mdarnell321/CubeSat-Hardware/Symbols/SFH_2240_A01/SFH_2240_A01.stp

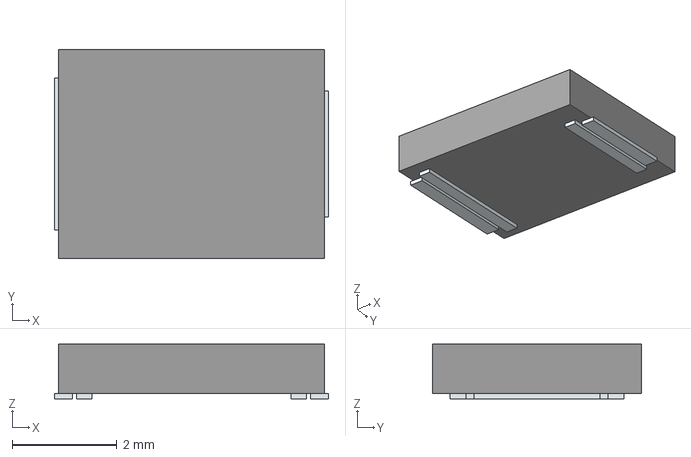
[picture p1: CAD file, 2025-11-14]
Symbols/SFH_2240_A01/SFH_2240_A01.stp
5.24 x 4.00 x 1.05 mm
Pins
