mdarnell321/CubeSat-Hardware/(list of files, cad)

Other CAD files:
Symbols/SFH_2240_A01/SFH_2240_A01.stl
