mdarnell321/CubeSat-Hardware/PDF/Electrical Power System.pdf

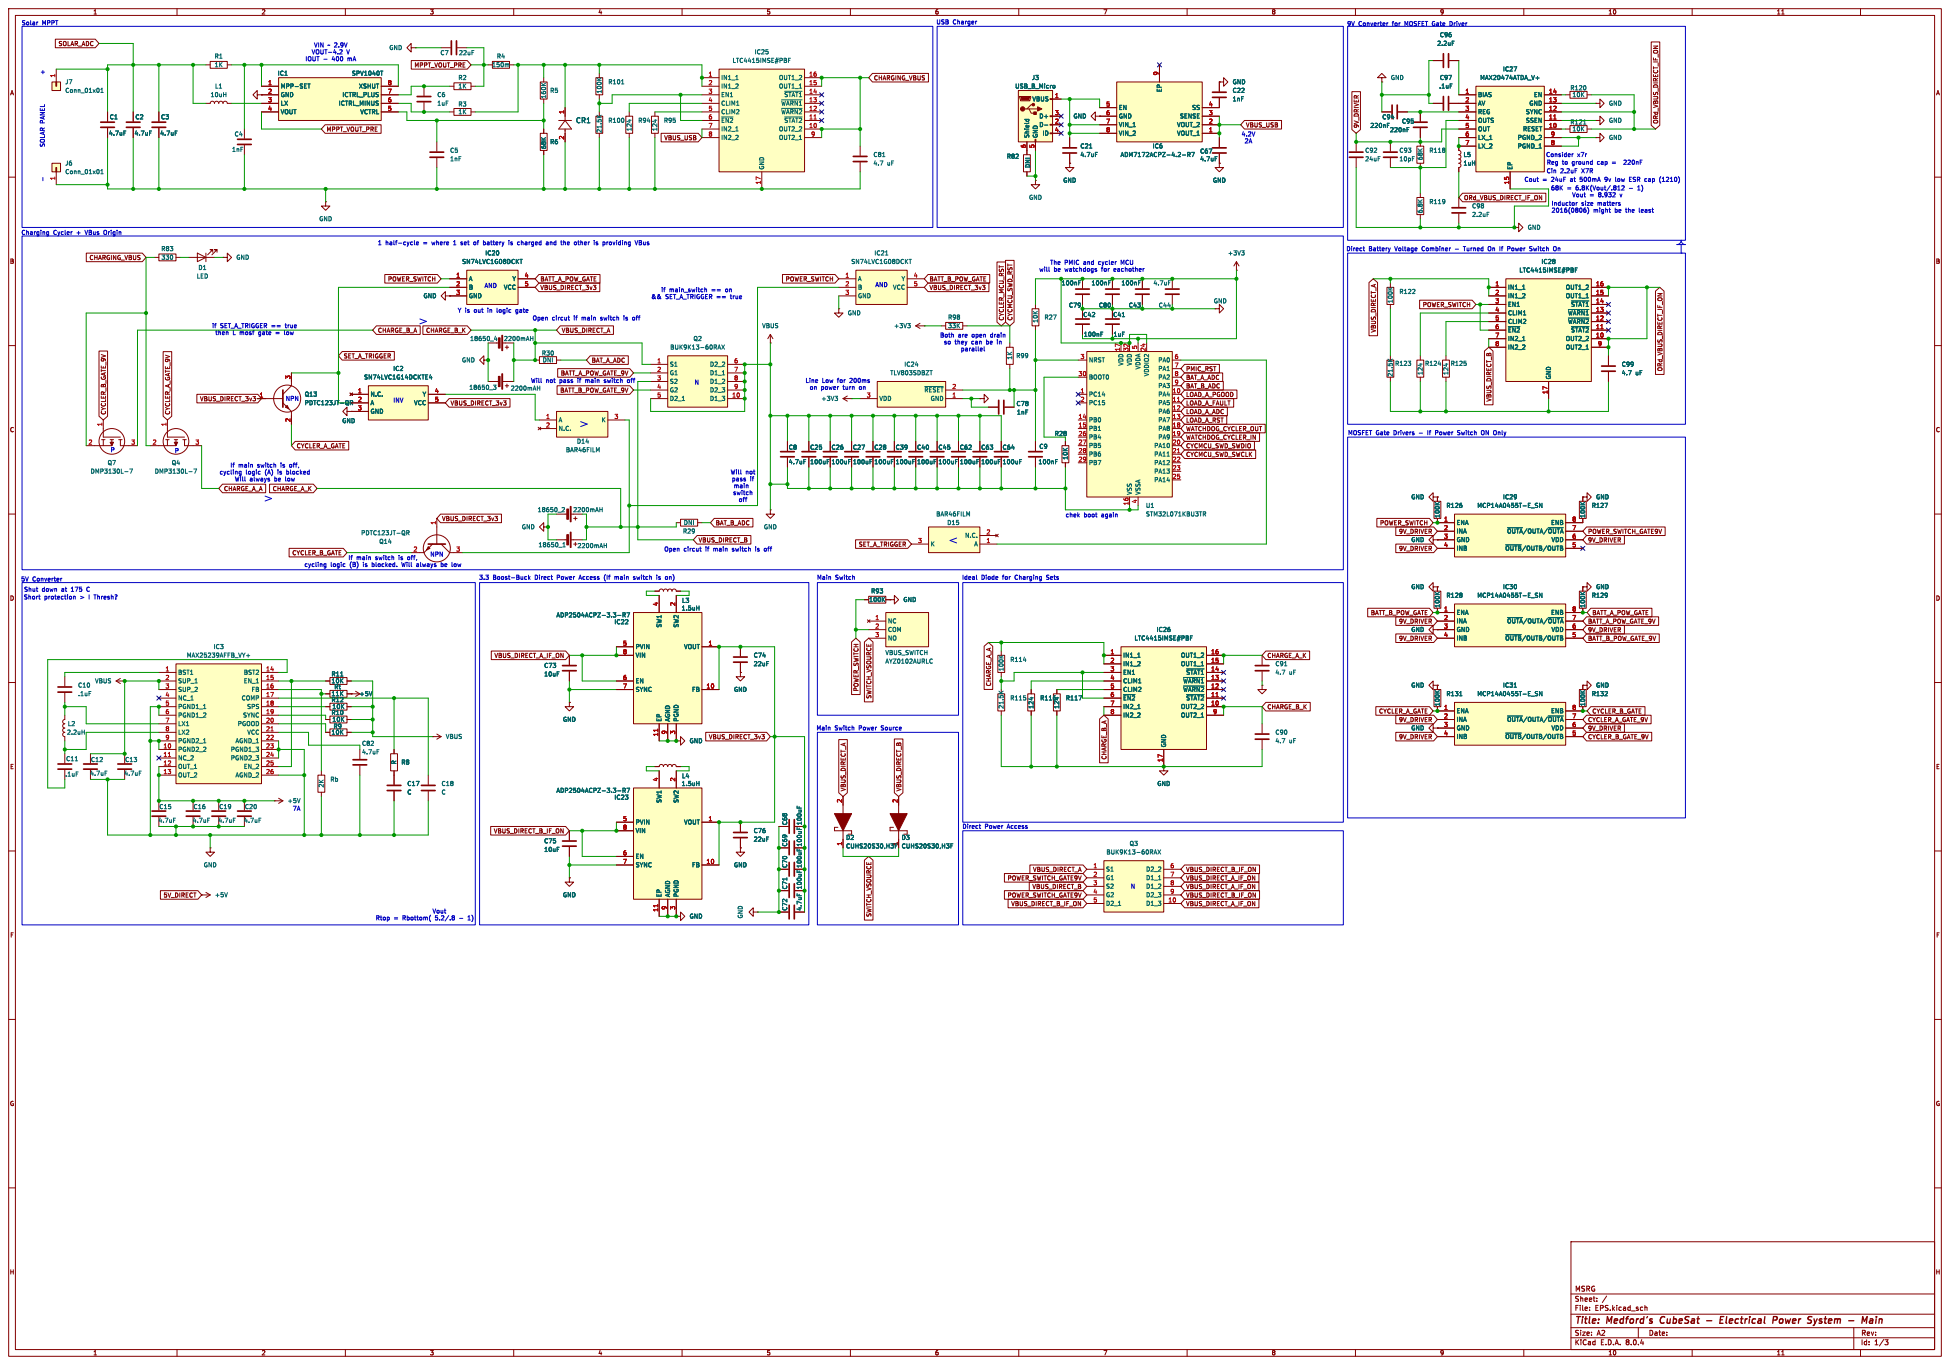
[picture p3: page 1]

9V Converter for MOSFET Gate Driver >

The PMIC and cycler MCU

Y is out in logic gate

off Open circut if main switch is off >

if SET_A_TRIGGER == true
then L mosf gate = low

Both are open drain
so they can be in

Line Low for 200ms on power turn on N

MOSFET Gate Drivers - If Power Switch ON Only

If main switch is off, cycling logic (A) is blocked Will always be low

Direct Power Access Main Switch >

chek boot again Vout

6 ~{OUTA}/OUTA/~{OUTA}7 ENB

5V Converter Shut down at 175 C

Ideal Diode for Charging Sets

4 PVIN 5 EN 6 SYNC 7 VIN 8 AGND

File: EPS.kicad_sch Sheet: / MSRG

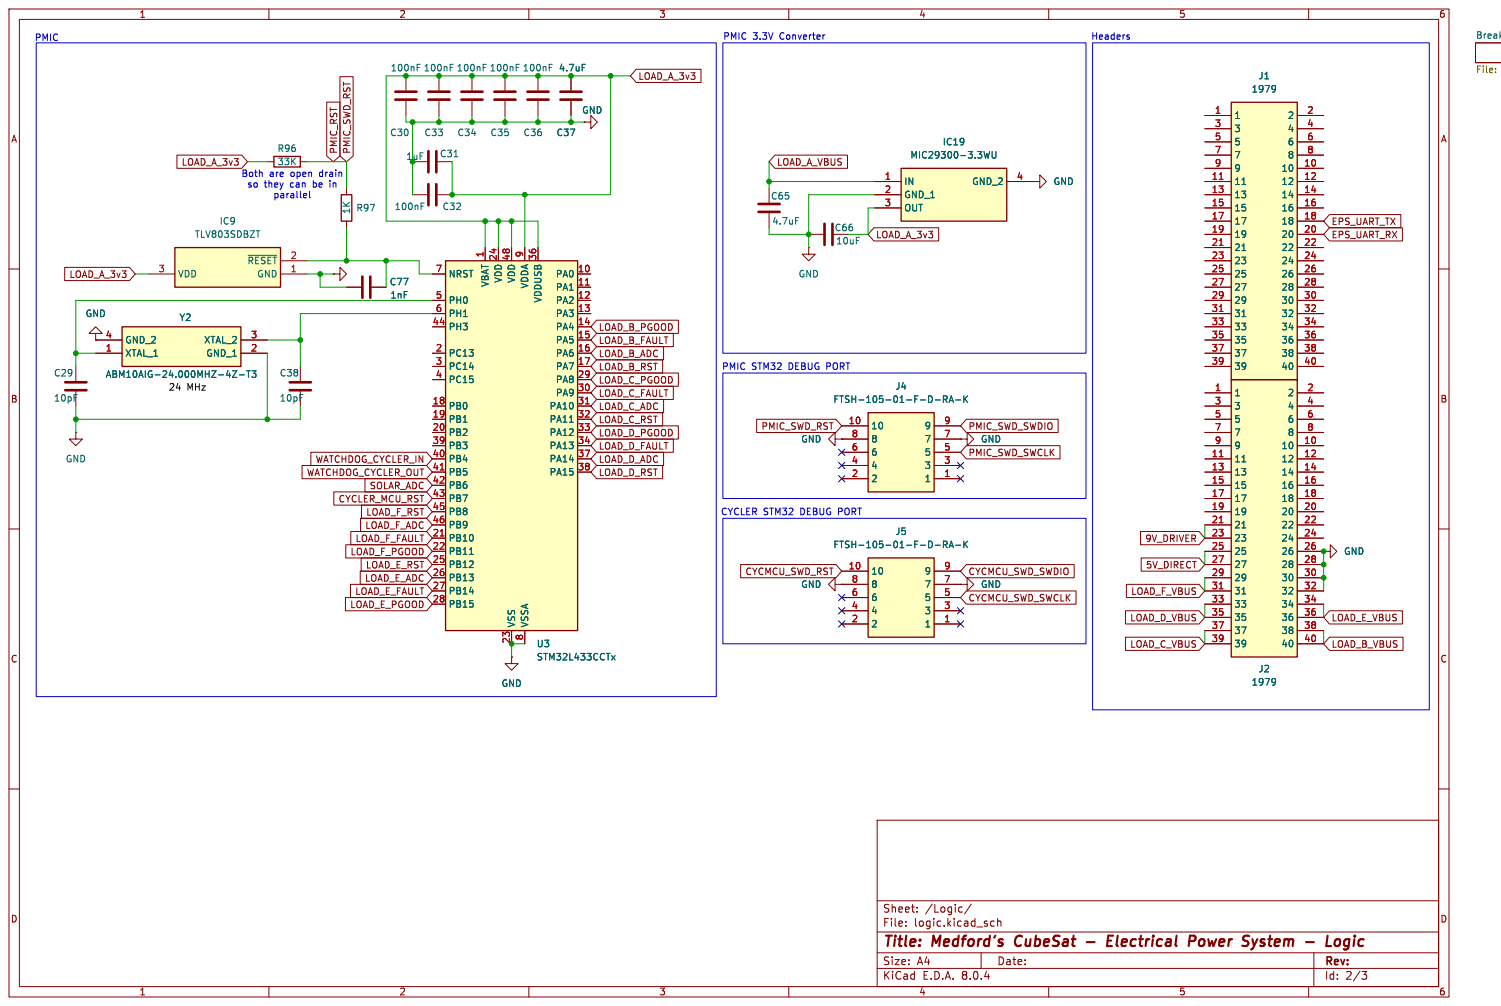
[picture p4: page 2]

Breaker File: Breaker.kicad_sch GND

so they can be in

9 U3STM32L433CCTx GND GND 1 ~{RESET}2 VDD 3

1 PA0 10 PA1 11 PA2 12 PA3 13 PA4 14 PA5 15 PA6 16 PA7 17 PB0 18 PB1 19 PC13 2 PB2 20 PB10 21 PB11 22 VSS 23 VDD 24 PB12 25 PB13 26 PB14 27 PB15 28 PA8 29 PC14 3 PA9 30 PA10 31 PA11 32 PA12 33 PA13 34 VDDUSB 36 PA14 37 PA15 38 PB3 39 PC15 4 PB4 40 PB5 41 PB6 42 PB7 43 PH3 44 PB8 45 PB9 46 VDD 48 PH0 5 PH1 6 NRST 7 VSSA

File: logic.kicad_sch Sheet: /Logic/
Id: 2/3 Title: Medford's CubeSat - Electrical Power System - Logic

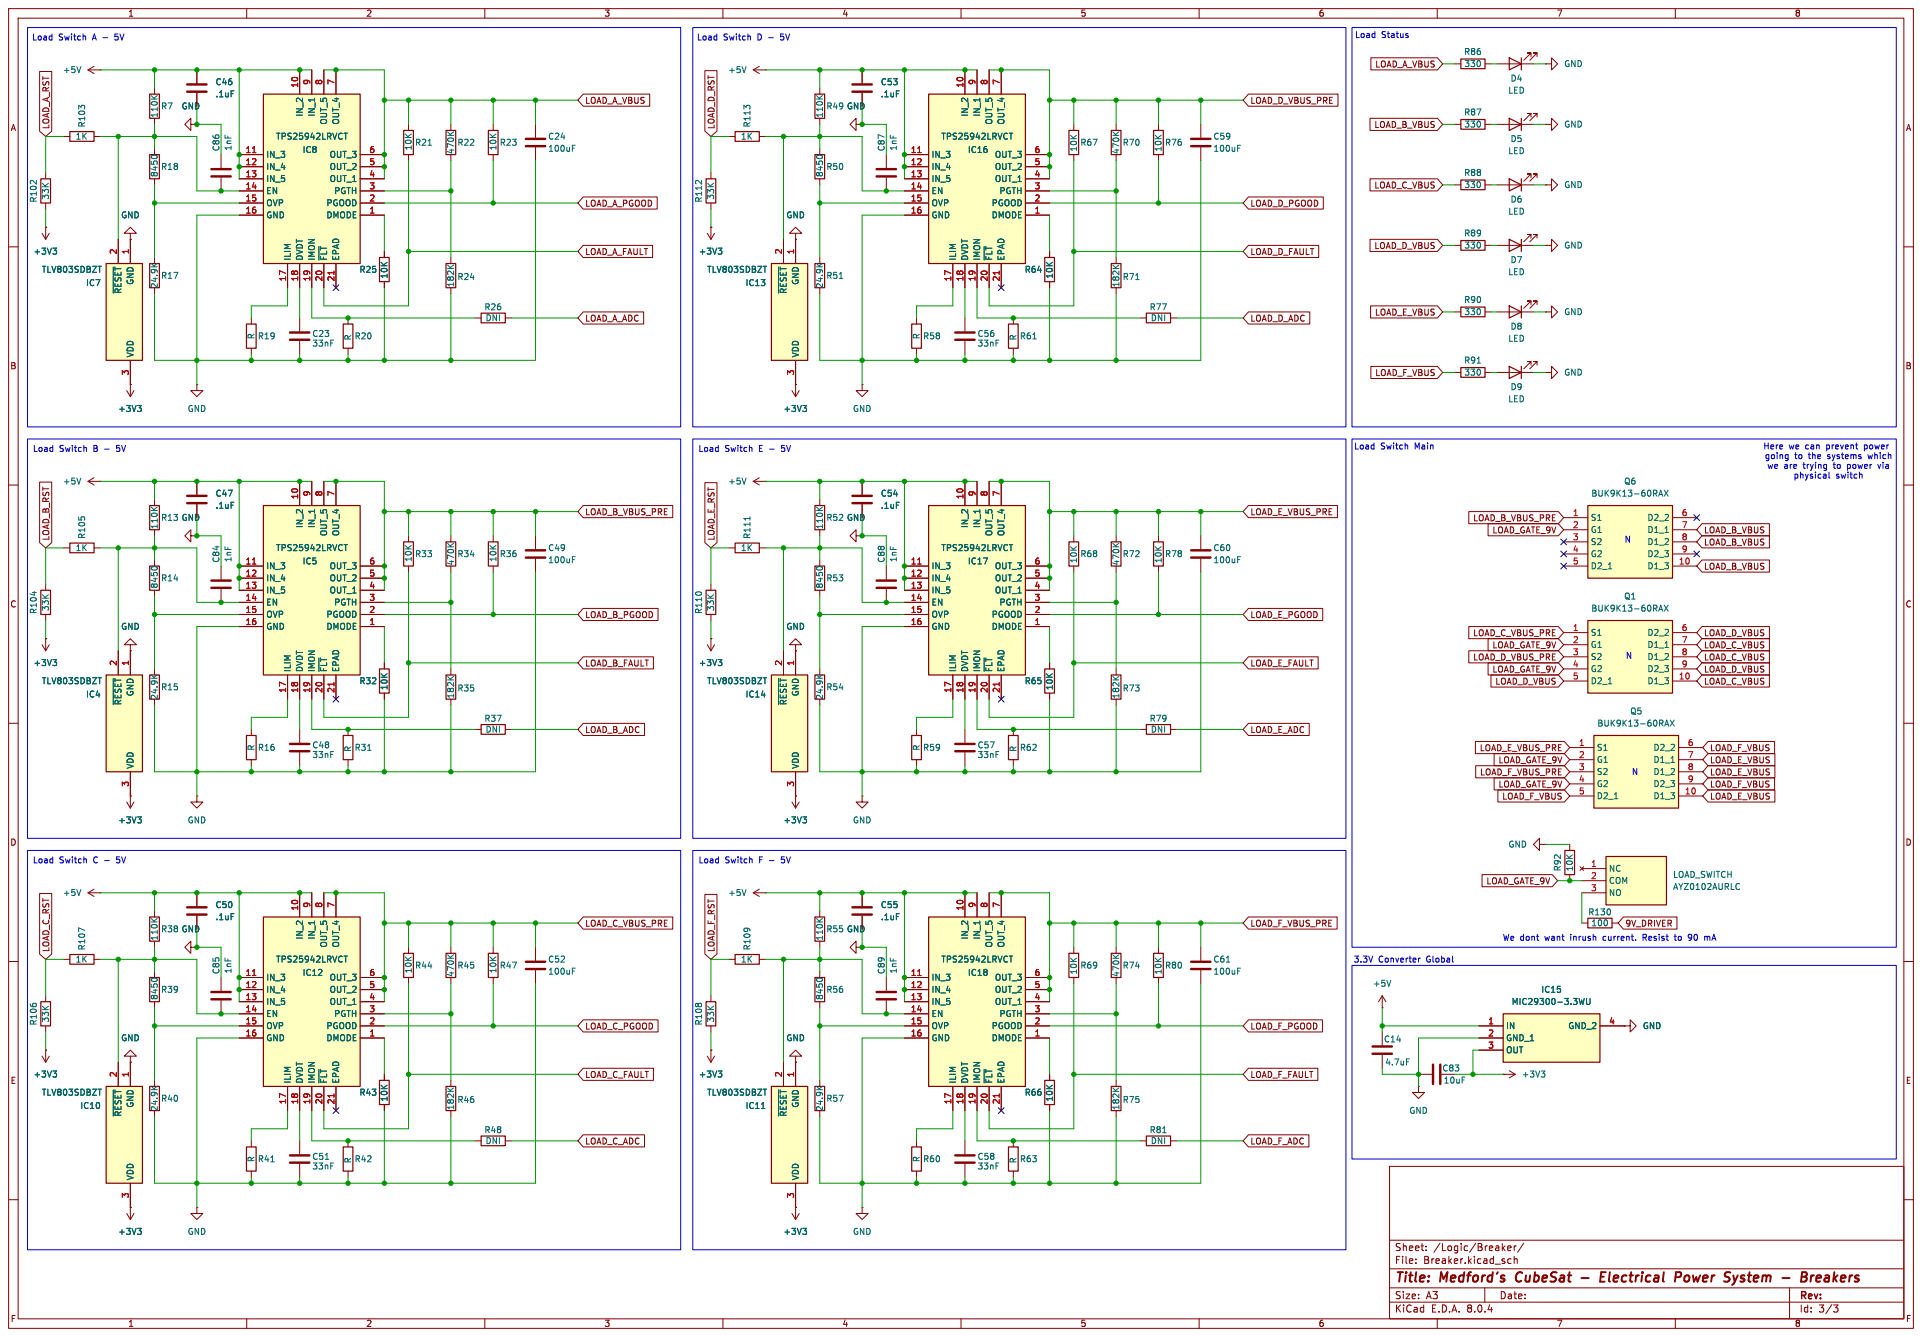
[picture p5: page 3]

Id: 3/3 Title: Medford's CubeSat - Electrical Power System - Breakers
