mdarnell321/CubeSat-Hardware/PDF/Flight Computer.pdf

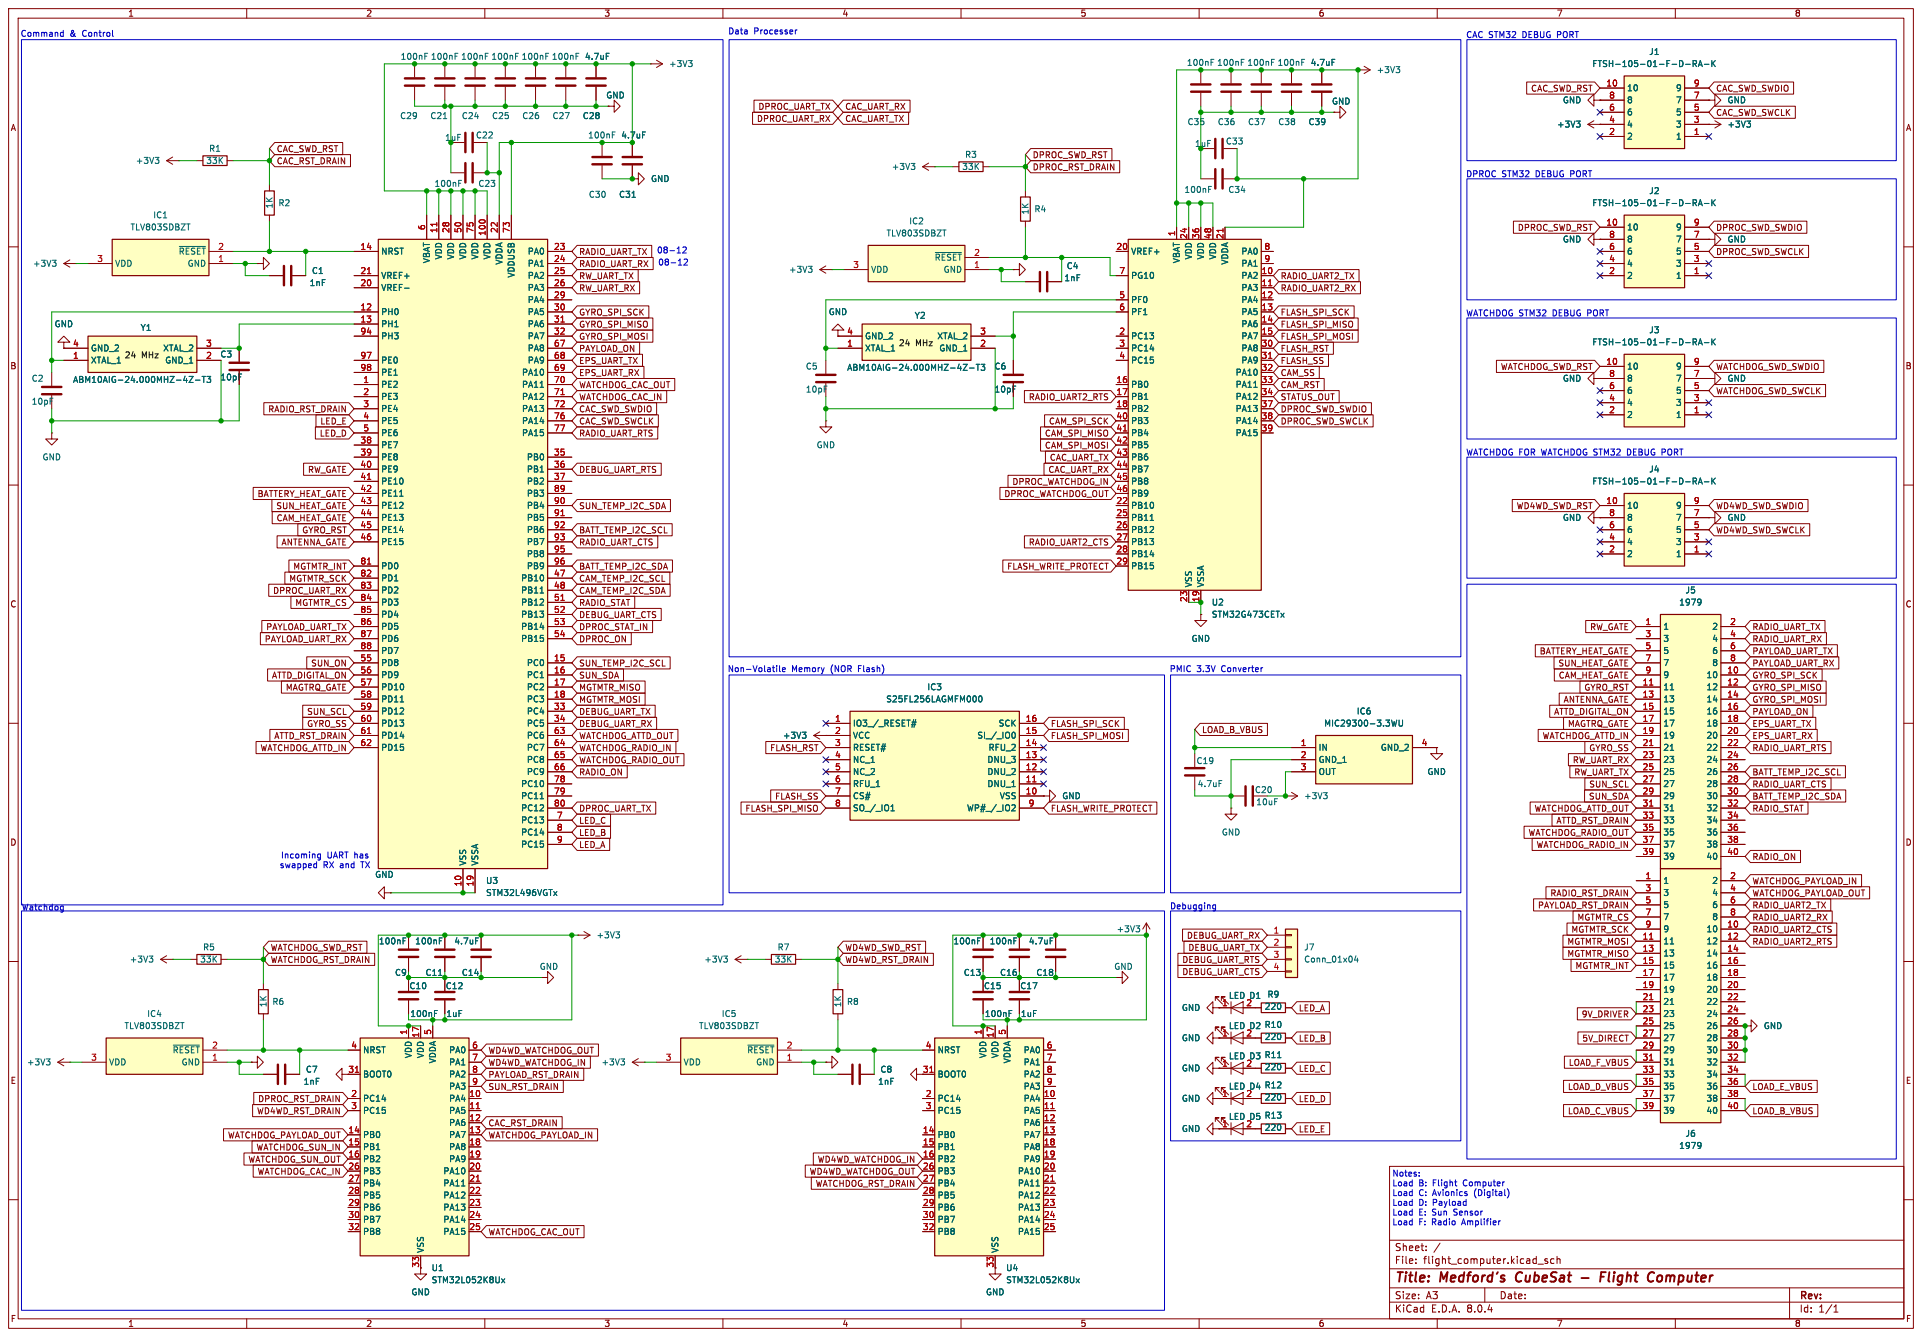
[picture p6: page 1]

1 PA2 10 PA3 11 PA4 12 PA5 13 PA6 14 PA7 15 PB0 16 PB1 17 PB2 18 VSSA 19 PC13 2 VREF+ 20 VDDA 21 PB10 22 VSS 23 VDD 24 PB11 25 PB12 26 PB13 27 PB14 28 PB15 29 PC14 3 PA8 30 PA9 31 PA10 32 PA11 33 PA12 34 VDD 36 PA13 37 PA14 38 PA15 39 PC15 4 PB3 40 PB4 41 PB5 42 PB6 43 PB7 44 PB8 45 PB9 46 VDD 48 PF0 5 PF1 6 PG10 7 PA0 8 PA1 9 U2STM32G473CETx C1

1 PA2 10 PA3 11 PA4 12 PA5 13 PA6 14 PA7 15 PB0 16 PB1 17 PB2 18 VSSA 19 PC13 2 VREF+ 20 VDDA 21 PB10 22 VSS 23 VDD 24 PB11 25 PB12 26 PB13 27 PB14 28 PB15 29 PC14 3 PA8 30 PA9 31 PA10 32 PA11 33 PA12 34 VDD 36 PA13 37 PA14 38 PA15 39 PC15 4 PB3 40 PB4 41 PB5 42 PB6 43 PB7 44 PB8 45 PB9 46 VDD 48 PF0 5 PF1 6 PG10 7 PA0 8 PA1 9 GND

swapped RX and TX

1 PA4 10 PA5 11 PA6 12 PA7 13 PB0 14 PB1 15 PB2 16 VDD 17 PA8 18 PA9 19 PC14 2 PA10 20 PA11 21 PA12 22 PA13 23 PA14 24 PA15 25 PB3 26 PB4 27 PB5 28 PB6 29 PC15 3 PB7 30 BOOT0 31 PB8 32 VSS 33 NRST 4 VDDA

Notes: Load B: Flight Computer Load C: Avionics (Digital) Load D: Payload

Load E: Sun Sensor Load F: Radio Amplifier

Id: 1/1 Title: Medford's CubeSat - Flight Computer File: flight_computer.kicad_sch Sheet: /
