mdarnell321/CubeSat-Hardware/PDF/Sun Sensor.pdf

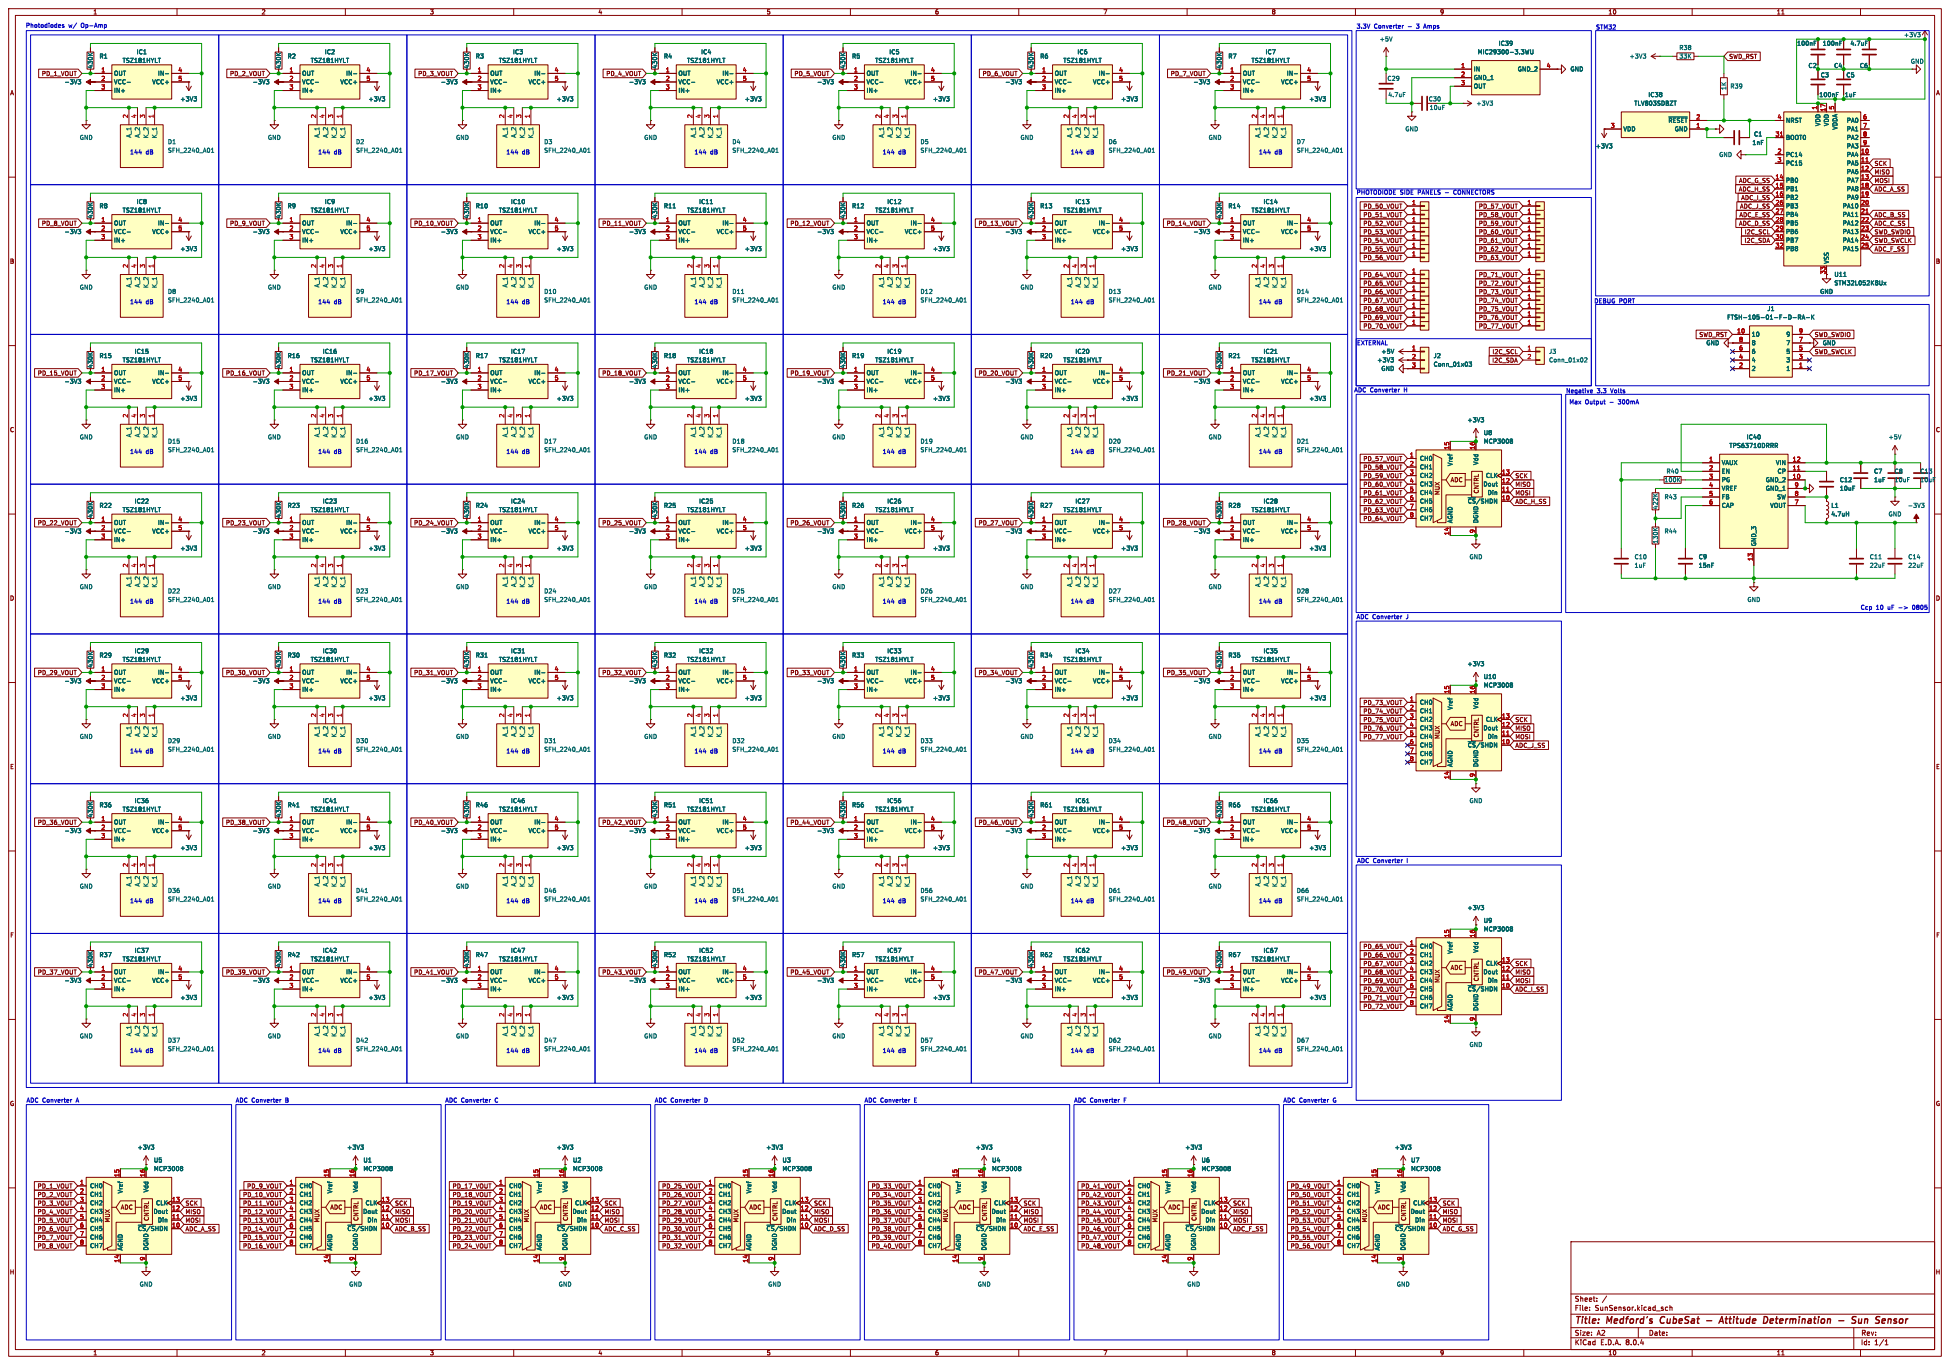
[picture p7: page 1]

3.3V Converter - 3 Amps PHOTODIODE SIDE PANELS - CONNECTORS

9 U7 MCP3008 +3V3 +3V3 ADC MUX CNTRL CH0 1 ~{CS}/SHDN

9 U3 MCP3008 CH0 1 ~{CS}/SHDN10 Din 11 Dout 12 CLK 13 AGND 14 Vref 15 Vdd 16 CH1 2 CH2 3 CH3 4 CH4 5 CH5 6 CH6 7 CH7 8 DGND
