mdarnell321/CubeSat-Hardware/Designs/Sun Sensor/KiCad/SunSensor.kicad_pcb

## KiCad design Designs/Sun Sensor/KiCad/SunSensor.kicad_pcb (2025-11-14)

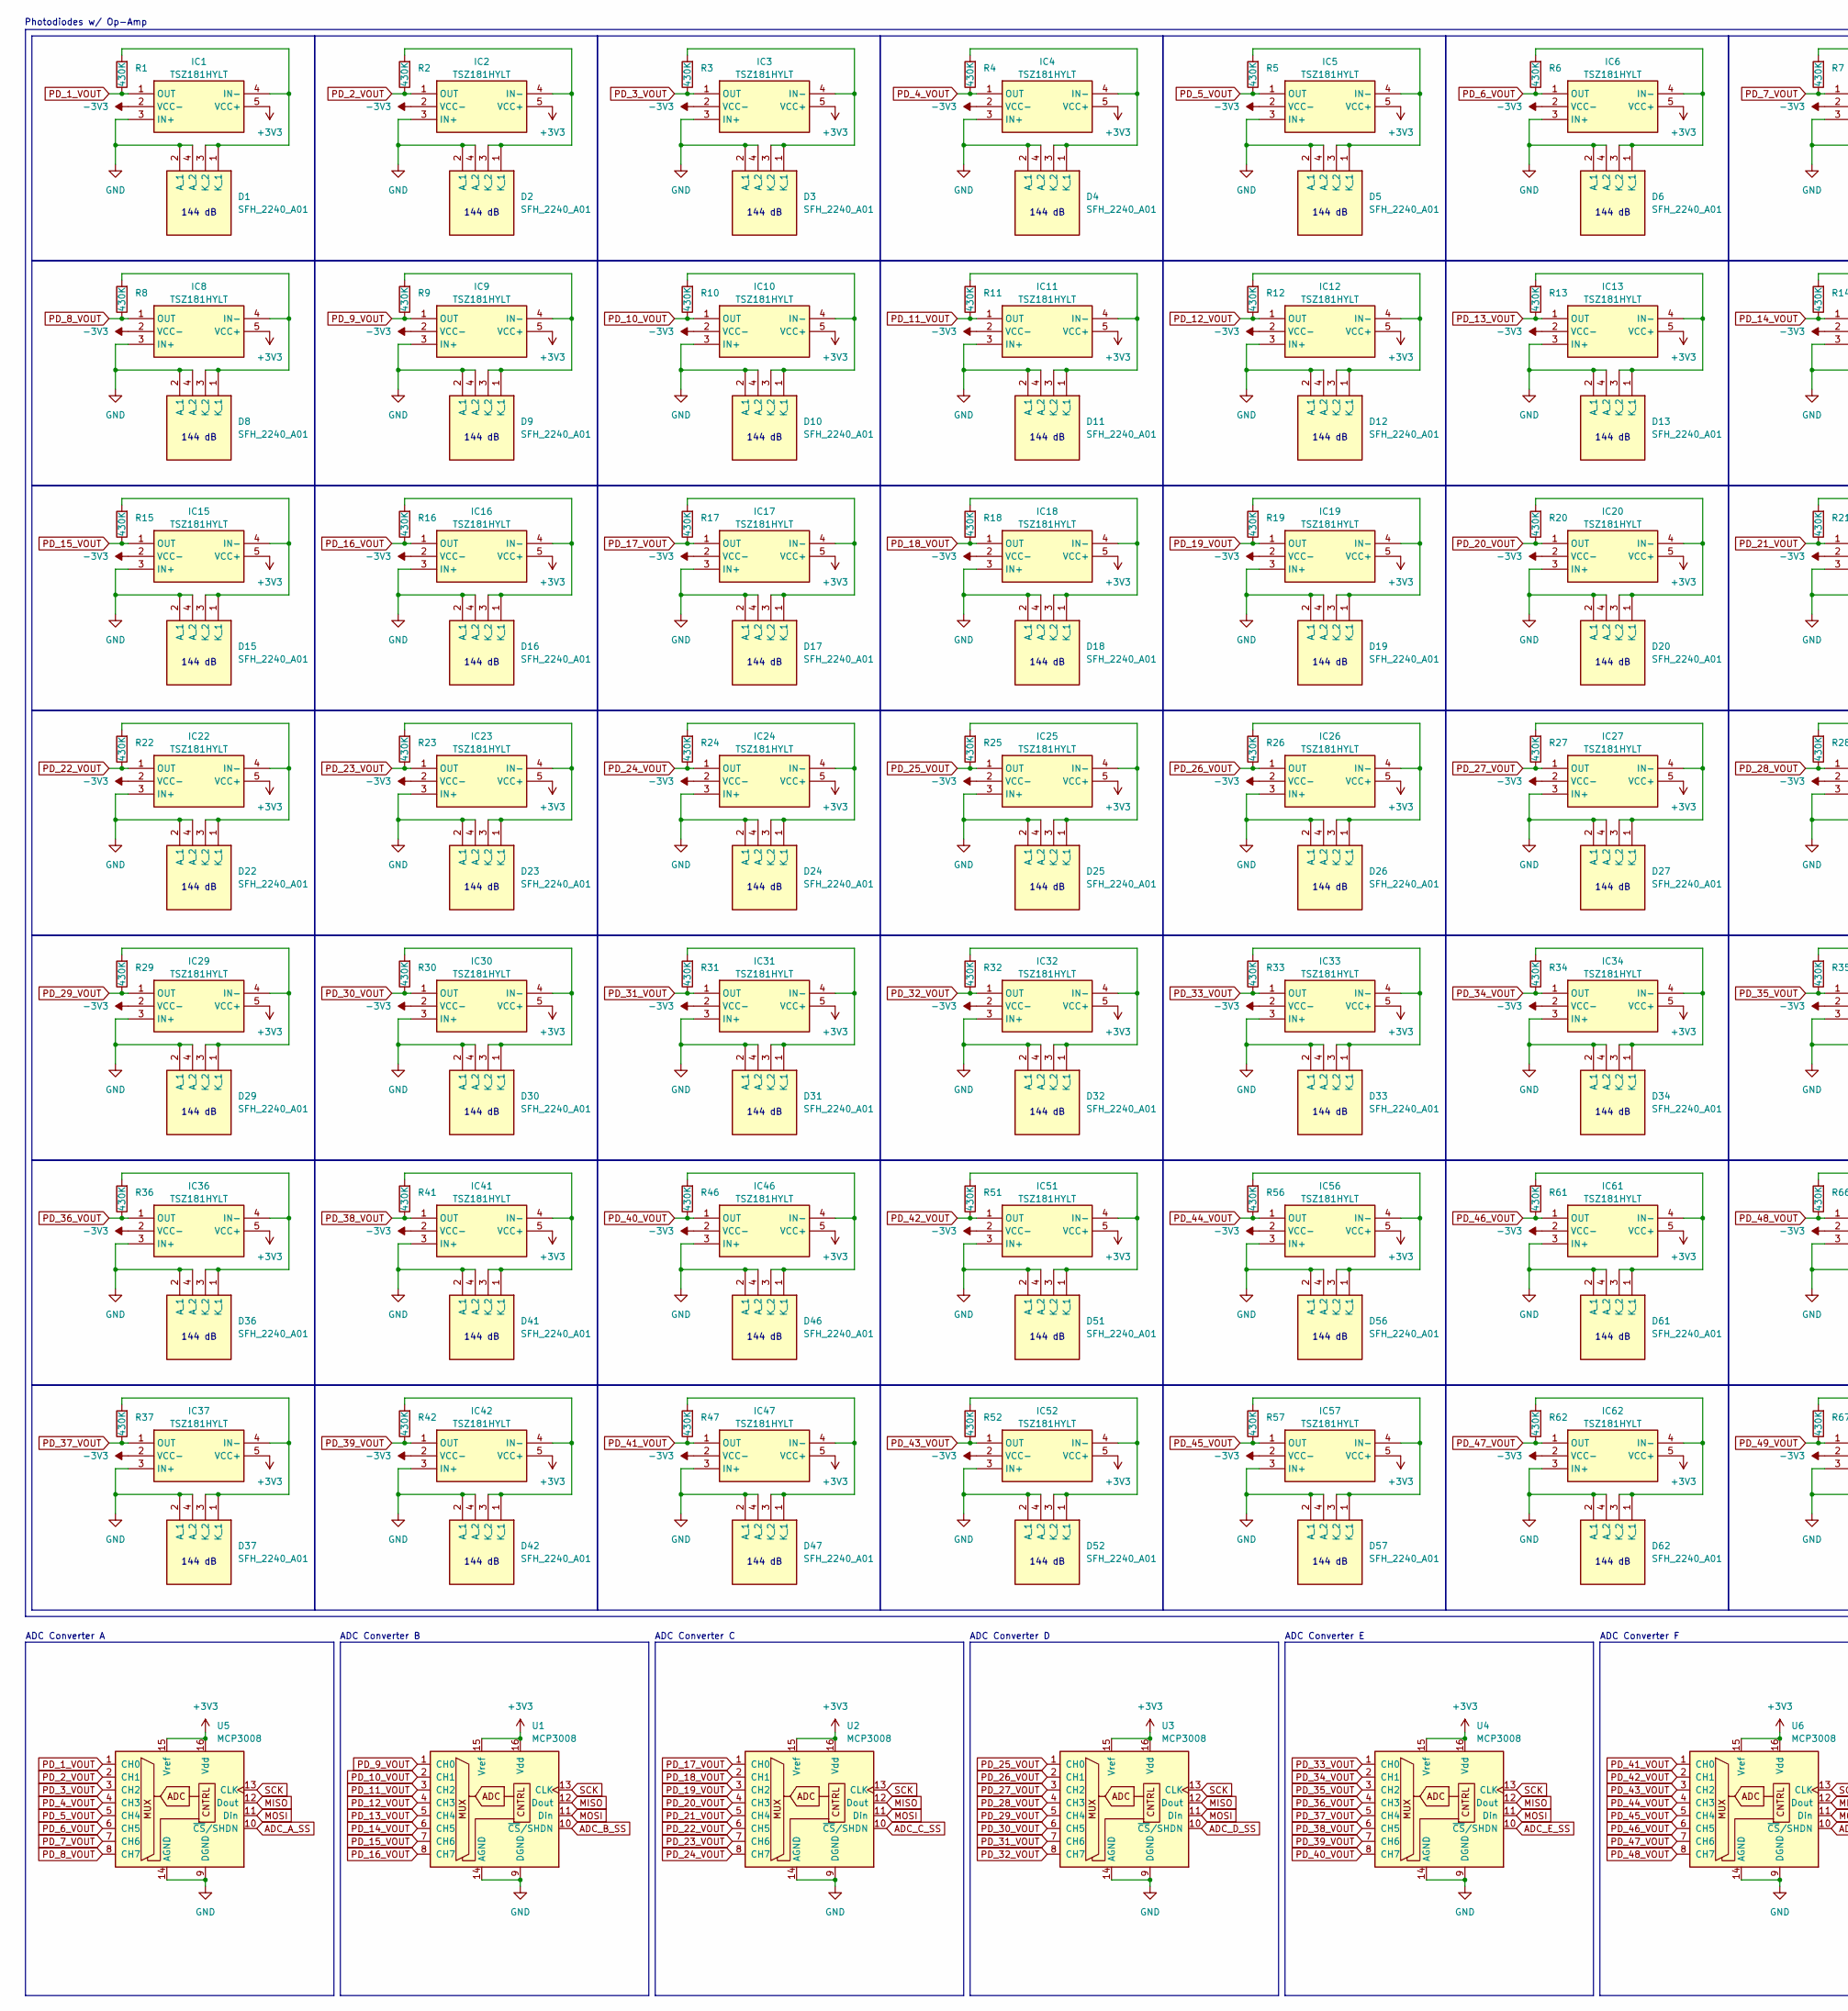
[picture p8: schematic SunSensor.kicad_sch, Medford's CubeSat - Attitude Determination - Sun Sensor, part in row 1, column 1]

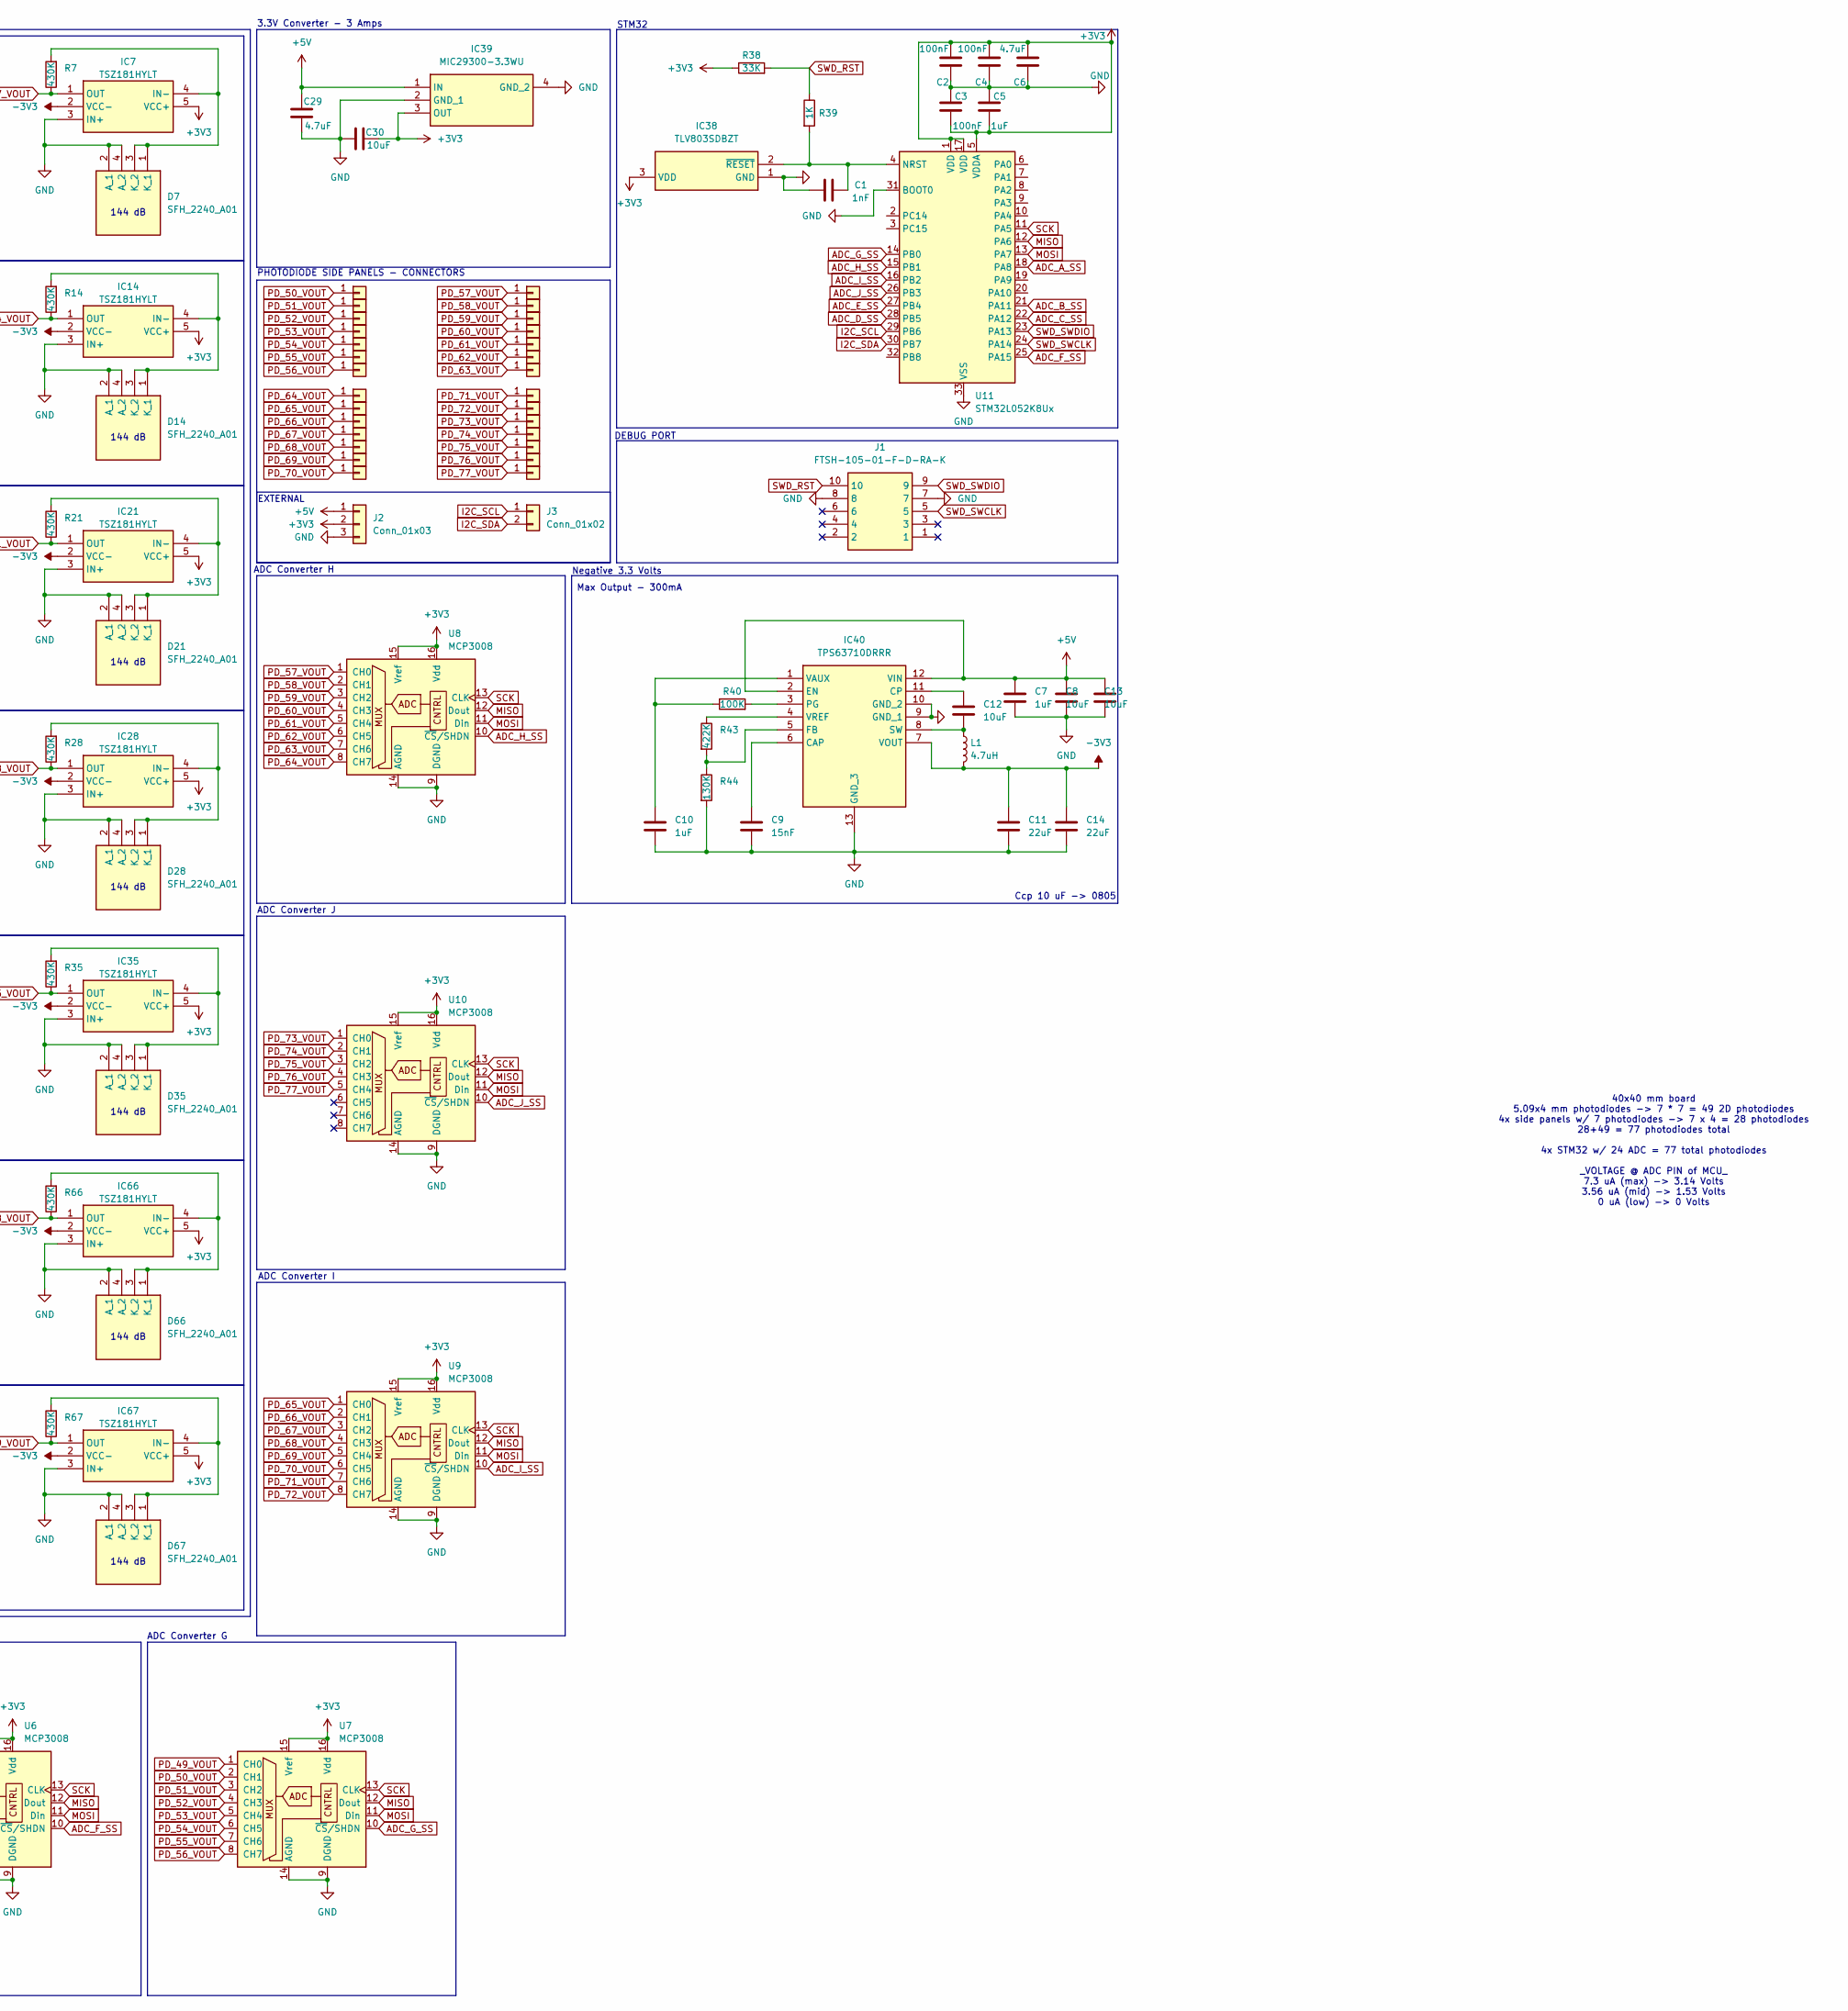
[picture p9: schematic SunSensor.kicad_sch, Medford's CubeSat - Attitude Determination - Sun Sensor, part in row 1, column 2]

Parts:
C1: 1nF; C_0603_1608Metric
C2, C3, C4: 100nF; C_0603_1608Metric
C5, C7, C10: 1uF; C_0603_1608Metric
C6, C29: 4.7uF; C_0603_1608Metric
C8, C12, C13: 10uF; C_1206_3216Metric
C9: 15nF; C_01005_0402Metric
C11, C14: 22uF; C_0805_2012Metric
C30: 10uF; C_0603_1608Metric
D1, D2, D3, D4, D5, D6, D7, D8, D9, D10, D11, D12, D13, D14, D15, D16, D17, D18, D19, D20, D21, D22, D23, D24, D25, D26, D27, D28, D29, D30, D31, D32, D33, D34, D35, D36, D37, D41, D42, D46, D47, D51, D52, D56, D57, D61, D62, D66, D67: SFH_2240_A01; SFH2240A01; Mouser Part Number 720-SFH2240A01
IC1, IC2, IC3, IC4, IC5, IC6, IC7, IC8, IC9, IC10, IC11, IC12, IC13, IC14, IC15, IC16, IC17, IC18, IC19, IC20, IC21, IC22, IC23, IC24, IC25, IC26, IC27, IC28, IC29, IC30, IC31, IC32, IC33, IC34, IC35, IC36, IC37, IC41, IC42, IC46, IC47, IC51, IC52, IC56, IC57, IC61, IC62, IC66, IC67: TSZ181HYLT; SOT95P280X145-5N; Mouser Part Number 511-TSZ181HYLT
IC38: TLV803SDBZT; SOT95P237X95-3N; Mouser Part Number 595-TLV803SDBZT
IC39: MIC29300-3.3WU; MIC2930033WU; Mouser Part Number 998-MIC29300-3.3WU
IC40: TPS63710DRRR; SON50P300X300X80-13N-D; Mouser Part Number 595-TPS63710DRRR
J1: FTSH-105-01-F-D-RA-K; FTSH-105-XX-YYY-D-RA-K; Mouser Part Number 200-FTSH10501FDRAK
J2: Conn_01x03; PinHeader_1x03_P2.54mm_Vertical
J3: Conn_01x02; PinHeader_1x02_P2.54mm_Vertical
J4, J5, J6, J7, J8, J9, J10, J11, J12, J13, J14, J15, J16, J17, J18, J19, J20, J21, J22, J23, J24, J25, J26, J27, J28, J29, J30, J31: Conn_01x01; PinHeader_1x01_P2.54mm_Vertical
L1: 4.7uH; L_Vishay_IFSC-1515AH_4x4x1.8mm
R1, R2, R3, R4, R5, R6, R7, R8, R9, R10, R11, R12, R13, R14, R15, R16, R17, R18, R19, R20, R21, R22, R23, R24, R25, R26, R27, R28, R29, R30, R31, R32, R33, R34, R35, R36, R37, R41, R42, R46, R47, R51, R52, R56, R57, R61, R62, R66, R67: 430K; R_0603_1608Metric_Pad0.98x0.95mm_HandSolder
R38: 33K; R_0603_1608Metric
R39: 1K; R_0603_1608Metric
R40: 100K; R_0402_1005Metric
R43: 422K; R_0402_1005Metric
R44: 130K; R_0402_1005Metric
U1, U2, U3, U4, U5, U6, U7, U8, U9, U10: MCP3008; SOIC127P600X175-16N
U11: STM32L052K8Ux; QFN-32-1EP_5x5mm_P0.5mm_EP3.45x3.45mm

Connections:
+3V3: C2.2, C3.1, C4.2, C5.1, C6.2, C30.1, IC1.5 (VCC+), IC2.5 (VCC+), IC3.5 (VCC+), IC4.5 (VCC+), IC5.5 (VCC+), IC6.5 (VCC+), IC7.5 (VCC+), IC8.5 (VCC+), IC9.5 (VCC+), IC10.5 (VCC+), IC11.5 (VCC+), IC12.5 (VCC+), IC13.5 (VCC+), IC14.5 (VCC+), IC15.5 (VCC+), IC16.5 (VCC+), IC17.5 (VCC+), IC18.5 (VCC+), IC19.5 (VCC+), IC20.5 (VCC+), IC21.5 (VCC+), IC22.5 (VCC+), IC23.5 (VCC+), IC24.5 (VCC+), IC25.5 (VCC+), IC26.5 (VCC+), IC27.5 (VCC+), IC28.5 (VCC+), IC29.5 (VCC+), IC30.5 (VCC+), IC31.5 (VCC+), IC32.5 (VCC+), IC33.5 (VCC+), IC34.5 (VCC+), IC35.5 (VCC+), IC36.5 (VCC+), IC37.5 (VCC+), IC38.3 (VDD), IC39.3 (OUT), IC41.5 (VCC+), IC42.5 (VCC+), IC46.5 (VCC+), IC47.5 (VCC+), IC51.5 (VCC+), IC52.5 (VCC+), IC56.5 (VCC+), IC57.5 (VCC+), IC61.5 (VCC+), IC62.5 (VCC+), IC66.5 (VCC+), IC67.5 (VCC+), J2.2, R38.1, U1.15 (Vref), U1.16 (Vdd), U2.15 (Vref), U2.16 (Vdd), U3.15 (Vref), U3.16 (Vdd), U4.15 (Vref), U4.16 (Vdd), U5.15 (Vref), U5.16 (Vdd), U6.15 (Vref), U6.16 (Vdd), U7.15 (Vref), U7.16 (Vdd), U8.15 (Vref), U8.16 (Vdd), U9.15 (Vref), U9.16 (Vdd), U10.15 (Vref), U10.16 (Vdd), U11.1 (VDD), U11.5 (VDDA), U11.17 (VDD)
+5V: C7.1, C8.1, C13.1, C29.1, IC39.1 (IN), IC40.2 (EN), IC40.12 (VIN), J2.1
-3V3: C11.1, C14.1, IC1.2 (VCC-), IC2.2 (VCC-), IC3.2 (VCC-), IC4.2 (VCC-), IC5.2 (VCC-), IC6.2 (VCC-), IC7.2 (VCC-), IC8.2 (VCC-), IC9.2 (VCC-), IC10.2 (VCC-), IC11.2 (VCC-), IC12.2 (VCC-), IC13.2 (VCC-), IC14.2 (VCC-), IC15.2 (VCC-), IC16.2 (VCC-), IC17.2 (VCC-), IC18.2 (VCC-), IC19.2 (VCC-), IC20.2 (VCC-), IC21.2 (VCC-), IC22.2 (VCC-), IC23.2 (VCC-), IC24.2 (VCC-), IC25.2 (VCC-), IC26.2 (VCC-), IC27.2 (VCC-), IC28.2 (VCC-), IC29.2 (VCC-), IC30.2 (VCC-), IC31.2 (VCC-), IC32.2 (VCC-), IC33.2 (VCC-), IC34.2 (VCC-), IC35.2 (VCC-), IC36.2 (VCC-), IC37.2 (VCC-), IC40.7 (VOUT), IC41.2 (VCC-), IC42.2 (VCC-), IC46.2 (VCC-), IC47.2 (VCC-), IC51.2 (VCC-), IC52.2 (VCC-), IC56.2 (VCC-), IC57.2 (VCC-), IC61.2 (VCC-), IC62.2 (VCC-), IC66.2 (VCC-), IC67.2 (VCC-), L1.2
ADC_A_SS: U5.10 (~CS/SHDN), U11.18 (PA8)
ADC_B_SS: U1.10 (~CS/SHDN), U11.21 (PA11)
ADC_C_SS: U2.10 (~CS/SHDN), U11.22 (PA12)
ADC_D_SS: U3.10 (~CS/SHDN), U11.28 (PB5)
ADC_E_SS: U4.10 (~CS/SHDN), U11.27 (PB4)
ADC_F_SS: U6.10 (~CS/SHDN), U11.25 (PA15)
ADC_G_SS: U7.10 (~CS/SHDN), U11.14 (PB0)
ADC_H_SS: U8.10 (~CS/SHDN), U11.15 (PB1)
ADC_I_SS: U9.10 (~CS/SHDN), U11.16 (PB2)
ADC_J_SS: U10.10 (~CS/SHDN), U11.26 (PB3)
GND: C1.1, C2.1, C3.2, C4.1, C5.2, C6.1, C7.2, C8.2, C9.2, C10.2, C11.2, C13.2, C14.2, C29.2, C30.2, D1.2 (A_1), D1.4 (A_2), D2.2 (A_1), D2.4 (A_2), D3.2 (A_1), D3.4 (A_2), D4.2 (A_1), D4.4 (A_2), D5.2 (A_1), D5.4 (A_2), D6.2 (A_1), D6.4 (A_2), D7.2 (A_1), D7.4 (A_2), D8.2 (A_1), D8.4 (A_2), D9.2 (A_1), D9.4 (A_2), D10.2 (A_1), D10.4 (A_2), D11.2 (A_1), D11.4 (A_2), D12.2 (A_1), D12.4 (A_2), D13.2 (A_1), D13.4 (A_2), D14.2 (A_1), D14.4 (A_2), D15.2 (A_1), D15.4 (A_2), D16.2 (A_1), D16.4 (A_2), D17.2 (A_1), D17.4 (A_2), D18.2 (A_1), D18.4 (A_2), D19.2 (A_1), D19.4 (A_2), D20.2 (A_1), D20.4 (A_2), D21.2 (A_1), D21.4 (A_2), D22.2 (A_1), D22.4 (A_2), D23.2 (A_1), D23.4 (A_2), D24.2 (A_1), D24.4 (A_2), D25.2 (A_1), D25.4 (A_2), D26.2 (A_1), D26.4 (A_2), D27.2 (A_1), D27.4 (A_2), D28.2 (A_1), D28.4 (A_2), D29.2 (A_1), D29.4 (A_2), D30.2 (A_1), D30.4 (A_2), D31.2 (A_1), D31.4 (A_2), D32.2 (A_1), D32.4 (A_2), D33.2 (A_1), D33.4 (A_2), D34.2 (A_1), D34.4 (A_2), D35.2 (A_1), D35.4 (A_2), D36.2 (A_1), D36.4 (A_2), D37.2 (A_1), D37.4 (A_2), D41.2 (A_1), D41.4 (A_2), D42.2 (A_1), D42.4 (A_2), D46.2 (A_1), D46.4 (A_2), D47.2 (A_1), D47.4 (A_2), D51.2 (A_1), D51.4 (A_2), D52.2 (A_1), D52.4 (A_2), D56.2 (A_1), D56.4 (A_2), D57.2 (A_1), D57.4 (A_2), D61.2 (A_1), D61.4 (A_2), D62.2 (A_1), D62.4 (A_2), D66.2 (A_1), D66.4 (A_2), D67.2 (A_1), D67.4 (A_2), IC1.3 (IN+), IC2.3 (IN+), IC3.3 (IN+), IC4.3 (IN+), IC5.3 (IN+), IC6.3 (IN+), IC7.3 (IN+), IC8.3 (IN+), IC9.3 (IN+), IC10.3 (IN+), IC11.3 (IN+), IC12.3 (IN+), IC13.3 (IN+), IC14.3 (IN+), IC15.3 (IN+), IC16.3 (IN+), IC17.3 (IN+), IC18.3 (IN+), IC19.3 (IN+), IC20.3 (IN+), IC21.3 (IN+), IC22.3 (IN+), IC23.3 (IN+), IC24.3 (IN+), IC25.3 (IN+), IC26.3 (IN+), IC27.3 (IN+), IC28.3 (IN+), IC29.3 (IN+), IC30.3 (IN+), IC31.3 (IN+), IC32.3 (IN+), IC33.3 (IN+), IC34.3 (IN+), IC35.3 (IN+), IC36.3 (IN+), IC37.3 (IN+), IC38.1 (GND), IC39.2 (GND_1), IC39.4 (GND_2), IC40.9 (GND_1), IC40.10 (GND_2), IC40.13 (GND_3), IC41.3 (IN+), IC42.3 (IN+), IC46.3 (IN+), IC47.3 (IN+), IC51.3 (IN+), IC52.3 (IN+), IC56.3 (IN+), IC57.3 (IN+), IC61.3 (IN+), IC62.3 (IN+), IC66.3 (IN+), IC67.3 (IN+), J1.7, J1.8, J2.3, R44.2, U1.9 (DGND), U1.14 (AGND), U2.9 (DGND), U2.14 (AGND), U3.9 (DGND), U3.14 (AGND), U4.9 (DGND), U4.14 (AGND), U5.9 (DGND), U5.14 (AGND), U6.9 (DGND), U6.14 (AGND), U7.9 (DGND), U7.14 (AGND), U8.9 (DGND), U8.14 (AGND), U9.9 (DGND), U9.14 (AGND), U10.9 (DGND), U10.14 (AGND), U11.31 (BOOT0), U11.33 (VSS)
MISO: U1.12 (Dout), U2.12 (Dout), U3.12 (Dout), U4.12 (Dout), U5.12 (Dout), U6.12 (Dout), U7.12 (Dout), U8.12 (Dout), U9.12 (Dout), U10.12 (Dout), U11.12 (PA6)
MOSI: U1.11 (Din), U2.11 (Din), U3.11 (Din), U4.11 (Din), U5.11 (Din), U6.11 (Din), U7.11 (Din), U8.11 (Din), U9.11 (Din), U10.11 (Din), U11.13 (PA7)
unnamed: D1.1 (K_1), D1.3 (K_2), IC1.4 (IN-), R1.2
unnamed: D2.1 (K_1), D2.3 (K_2), IC2.4 (IN-), R2.2
unnamed: D3.1 (K_1), D3.3 (K_2), IC3.4 (IN-), R3.2
unnamed: D4.1 (K_1), D4.3 (K_2), IC4.4 (IN-), R4.2
unnamed: D5.1 (K_1), D5.3 (K_2), IC5.4 (IN-), R5.2
unnamed: D6.1 (K_1), D6.3 (K_2), IC6.4 (IN-), R6.2
unnamed: D7.1 (K_1), D7.3 (K_2), IC7.4 (IN-), R7.2
unnamed: D8.1 (K_1), D8.3 (K_2), IC8.4 (IN-), R8.2
unnamed: D9.1 (K_1), D9.3 (K_2), IC9.4 (IN-), R9.2
unnamed: D10.1 (K_1), D10.3 (K_2), IC10.4 (IN-), R10.2
unnamed: D11.1 (K_1), D11.3 (K_2), IC11.4 (IN-), R11.2
unnamed: D12.1 (K_1), D12.3 (K_2), IC12.4 (IN-), R12.2
unnamed: D13.1 (K_1), D13.3 (K_2), IC13.4 (IN-), R13.2
unnamed: D14.1 (K_1), D14.3 (K_2), IC14.4 (IN-), R14.2
unnamed: D15.1 (K_1), D15.3 (K_2), IC15.4 (IN-), R15.2
unnamed: D16.1 (K_1), D16.3 (K_2), IC16.4 (IN-), R16.2
unnamed: D17.1 (K_1), D17.3 (K_2), IC17.4 (IN-), R17.2
unnamed: D18.1 (K_1), D18.3 (K_2), IC18.4 (IN-), R18.2
unnamed: D19.1 (K_1), D19.3 (K_2), IC19.4 (IN-), R19.2
unnamed: D20.1 (K_1), D20.3 (K_2), IC20.4 (IN-), R20.2
unnamed: D21.1 (K_1), D21.3 (K_2), IC21.4 (IN-), R21.2
unnamed: D22.1 (K_1), D22.3 (K_2), IC22.4 (IN-), R22.2
unnamed: D23.1 (K_1), D23.3 (K_2), IC23.4 (IN-), R23.2
unnamed: D24.1 (K_1), D24.3 (K_2), IC24.4 (IN-), R24.2
unnamed: D25.1 (K_1), D25.3 (K_2), IC25.4 (IN-), R25.2
unnamed: D26.1 (K_1), D26.3 (K_2), IC26.4 (IN-), R26.2
unnamed: D27.1 (K_1), D27.3 (K_2), IC27.4 (IN-), R27.2
unnamed: D28.1 (K_1), D28.3 (K_2), IC28.4 (IN-), R28.2
unnamed: D29.1 (K_1), D29.3 (K_2), IC29.4 (IN-), R29.2
unnamed: D30.1 (K_1), D30.3 (K_2), IC30.4 (IN-), R30.2
unnamed: D31.1 (K_1), D31.3 (K_2), IC31.4 (IN-), R31.2
unnamed: D32.1 (K_1), D32.3 (K_2), IC32.4 (IN-), R32.2
unnamed: D33.1 (K_1), D33.3 (K_2), IC33.4 (IN-), R33.2
unnamed: D34.1 (K_1), D34.3 (K_2), IC34.4 (IN-), R34.2
unnamed: D35.1 (K_1), D35.3 (K_2), IC35.4 (IN-), R35.2
unnamed: D36.1 (K_1), D36.3 (K_2), IC36.4 (IN-), R36.2
unnamed: D37.1 (K_1), D37.3 (K_2), IC37.4 (IN-), R37.2
unnamed: D41.1 (K_1), D41.3 (K_2), IC41.4 (IN-), R41.2
unnamed: D42.1 (K_1), D42.3 (K_2), IC42.4 (IN-), R42.2
unnamed: D46.1 (K_1), D46.3 (K_2), IC46.4 (IN-), R46.2
unnamed: D47.1 (K_1), D47.3 (K_2), IC47.4 (IN-), R47.2
unnamed: D51.1 (K_1), D51.3 (K_2), IC51.4 (IN-), R51.2
unnamed: D52.1 (K_1), D52.3 (K_2), IC52.4 (IN-), R52.2
unnamed: D56.1 (K_1), D56.3 (K_2), IC56.4 (IN-), R56.2
unnamed: D57.1 (K_1), D57.3 (K_2), IC57.4 (IN-), R57.2
unnamed: D61.1 (K_1), D61.3 (K_2), IC61.4 (IN-), R61.2
unnamed: D62.1 (K_1), D62.3 (K_2), IC62.4 (IN-), R62.2
unnamed: D66.1 (K_1), D66.3 (K_2), IC66.4 (IN-), R66.2
unnamed: D67.1 (K_1), D67.3 (K_2), IC67.4 (IN-), R67.2
unnamed: C1.2, IC38.2 (~RESET), R39.2, U11.4 (NRST)
unnamed: C9.1, IC40.6 (CAP)
unnamed: C12.1, IC40.11 (CP)
unnamed: IC40.5 (FB), R43.2, R44.1
unnamed: IC40.3 (PG), R40.2
unnamed: C12.2, IC40.8 (SW), L1.1
unnamed: C10.1, IC40.1 (VAUX), R40.1
unnamed: IC40.4 (VREF), R43.1
PD_1_VOUT: IC1.1 (OUT), R1.1, U5.1 (CH0)
PD_2_VOUT: IC2.1 (OUT), R2.1, U5.2 (CH1)
PD_3_VOUT: IC3.1 (OUT), R3.1, U5.3 (CH2)
PD_4_VOUT: IC4.1 (OUT), R4.1, U5.4 (CH3)
PD_5_VOUT: IC5.1 (OUT), R5.1, U5.5 (CH4)
PD_6_VOUT: IC6.1 (OUT), R6.1, U5.6 (CH5)
PD_7_VOUT: IC7.1 (OUT), R7.1, U5.7 (CH6)
PD_8_VOUT: IC8.1 (OUT), R8.1, U5.8 (CH7)
PD_9_VOUT: IC9.1 (OUT), R9.1, U1.1 (CH0)
PD_10_VOUT: IC10.1 (OUT), R10.1, U1.2 (CH1)
PD_11_VOUT: IC11.1 (OUT), R11.1, U1.3 (CH2)
PD_12_VOUT: IC12.1 (OUT), R12.1, U1.4 (CH3)
PD_13_VOUT: IC13.1 (OUT), R13.1, U1.5 (CH4)
PD_14_VOUT: IC14.1 (OUT), R14.1, U1.6 (CH5)
PD_15_VOUT: IC15.1 (OUT), R15.1, U1.7 (CH6)
PD_16_VOUT: IC16.1 (OUT), R16.1, U1.8 (CH7)
PD_17_VOUT: IC17.1 (OUT), R17.1, U2.1 (CH0)
PD_18_VOUT: IC18.1 (OUT), R18.1, U2.2 (CH1)
PD_19_VOUT: IC19.1 (OUT), R19.1, U2.3 (CH2)
PD_20_VOUT: IC20.1 (OUT), R20.1, U2.4 (CH3)
PD_21_VOUT: IC21.1 (OUT), R21.1, U2.5 (CH4)
PD_22_VOUT: IC22.1 (OUT), R22.1, U2.6 (CH5)
PD_23_VOUT: IC23.1 (OUT), R23.1, U2.7 (CH6)
PD_24_VOUT: IC24.1 (OUT), R24.1, U2.8 (CH7)
PD_25_VOUT: IC25.1 (OUT), R25.1, U3.1 (CH0)
PD_26_VOUT: IC26.1 (OUT), R26.1, U3.2 (CH1)
PD_27_VOUT: IC27.1 (OUT), R27.1, U3.3 (CH2)
PD_28_VOUT: IC28.1 (OUT), R28.1, U3.4 (CH3)
PD_29_VOUT: IC29.1 (OUT), R29.1, U3.5 (CH4)
PD_30_VOUT: IC30.1 (OUT), R30.1, U3.6 (CH5)
PD_31_VOUT: IC31.1 (OUT), R31.1, U3.7 (CH6)
PD_32_VOUT: IC32.1 (OUT), R32.1, U3.8 (CH7)
PD_33_VOUT: IC33.1 (OUT), R33.1, U4.1 (CH0)
PD_34_VOUT: IC34.1 (OUT), R34.1, U4.2 (CH1)
PD_35_VOUT: IC35.1 (OUT), R35.1, U4.3 (CH2)
PD_36_VOUT: IC36.1 (OUT), R36.1, U4.4 (CH3)
PD_37_VOUT: IC37.1 (OUT), R37.1, U4.5 (CH4)
PD_38_VOUT: IC41.1 (OUT), R41.1, U4.6 (CH5)
PD_39_VOUT: IC42.1 (OUT), R42.1, U4.7 (CH6)
PD_40_VOUT: IC46.1 (OUT), R46.1, U4.8 (CH7)
PD_41_VOUT: IC47.1 (OUT), R47.1, U6.1 (CH0)
PD_42_VOUT: IC51.1 (OUT), R51.1, U6.2 (CH1)
PD_43_VOUT: IC52.1 (OUT), R52.1, U6.3 (CH2)
PD_44_VOUT: IC56.1 (OUT), R56.1, U6.4 (CH3)
PD_45_VOUT: IC57.1 (OUT), R57.1, U6.5 (CH4)
PD_46_VOUT: IC61.1 (OUT), R61.1, U6.6 (CH5)
PD_47_VOUT: IC62.1 (OUT), R62.1, U6.7 (CH6)
PD_48_VOUT: IC66.1 (OUT), R66.1, U6.8 (CH7)
PD_49_VOUT: IC67.1 (OUT), R67.1, U7.1 (CH0)
PD_50_VOUT: J25.1, U7.2 (CH1)
PD_51_VOUT: J26.1, U7.3 (CH2)
PD_52_VOUT: J27.1, U7.4 (CH3)
PD_53_VOUT: J28.1, U7.5 (CH4)
PD_54_VOUT: J29.1, U7.6 (CH5)
PD_55_VOUT: J30.1, U7.7 (CH6)
PD_56_VOUT: J31.1, U7.8 (CH7)
PD_57_VOUT: J18.1, U8.1 (CH0)
PD_58_VOUT: J19.1, U8.2 (CH1)
PD_59_VOUT: J20.1, U8.3 (CH2)
PD_60_VOUT: J21.1, U8.4 (CH3)
PD_61_VOUT: J22.1, U8.5 (CH4)
PD_62_VOUT: J23.1, U8.6 (CH5)
PD_63_VOUT: J24.1, U8.7 (CH6)
PD_64_VOUT: J4.1, U8.8 (CH7)
PD_65_VOUT: J7.1, U9.1 (CH0)
PD_66_VOUT: J9.1, U9.2 (CH1)
PD_67_VOUT: J10.1, U9.3 (CH2)
PD_68_VOUT: J11.1, U9.4 (CH3)
PD_69_VOUT: J12.1, U9.5 (CH4)
PD_70_VOUT: J13.1, U9.6 (CH5)
PD_71_VOUT: J5.1, U9.7 (CH6)
PD_72_VOUT: J6.1, U9.8 (CH7)
PD_73_VOUT: J8.1, U10.1 (CH0)
PD_74_VOUT: J14.1, U10.2 (CH1)
PD_75_VOUT: J15.1, U10.3 (CH2)
PD_76_VOUT: J16.1, U10.4 (CH3)
PD_77_VOUT: J17.1, U10.5 (CH4)
SCK: U1.13 (CLK), U2.13 (CLK), U3.13 (CLK), U4.13 (CLK), U5.13 (CLK), U6.13 (CLK), U7.13 (CLK), U8.13 (CLK), U9.13 (CLK), U10.13 (CLK), U11.11 (PA5)
SWD_RST: J1.10, R38.2, R39.1
SWD_SWCLK: J1.5, U11.24 (PA14)
SWD_SWDIO: J1.9, U11.23 (PA13)
UART_RX: J3.1, U11.20 (PA10), U11.29 (PB6)
UART_TX: J3.2, U11.19 (PA9), U11.30 (PB7)

Notes on the sheet:
ADC Converter A
144 dB
Negative 3.3 Volts
ADC Converter E
ADC Converter D
ADC Converter C
Max Output - 300mA
EXTERNAL
ADC Converter I
ADC Converter B
Photodiodes w/ Op-Amp
STM32
3.3V Converter - 3 Amps
ADC Converter H
ADC Converter J
ADC Converter F
ADC Converter G
40x40 mm board 5.09x4 mm photodiodes -> 7 * 7 = 49 2D photodiodes 4x side panels w/ 7 photodiodes -> 7 x 4 = 28 photodiodes 28+49 = 77 photodiodes total 4x STM32 w/ 24 ADC = 77 total photodiodes _VOLTAGE @ ADC PIN of MCU_ 7.3 uA (max) -> 3.14 Volts 3.56 uA (mid) -> 1.53 Volts 0 uA (low) -> 0 Volts
DEBUG PORT
PHOTODIODE SIDE PANELS - CONNECTORS
Ccp 10 uF -> 0805

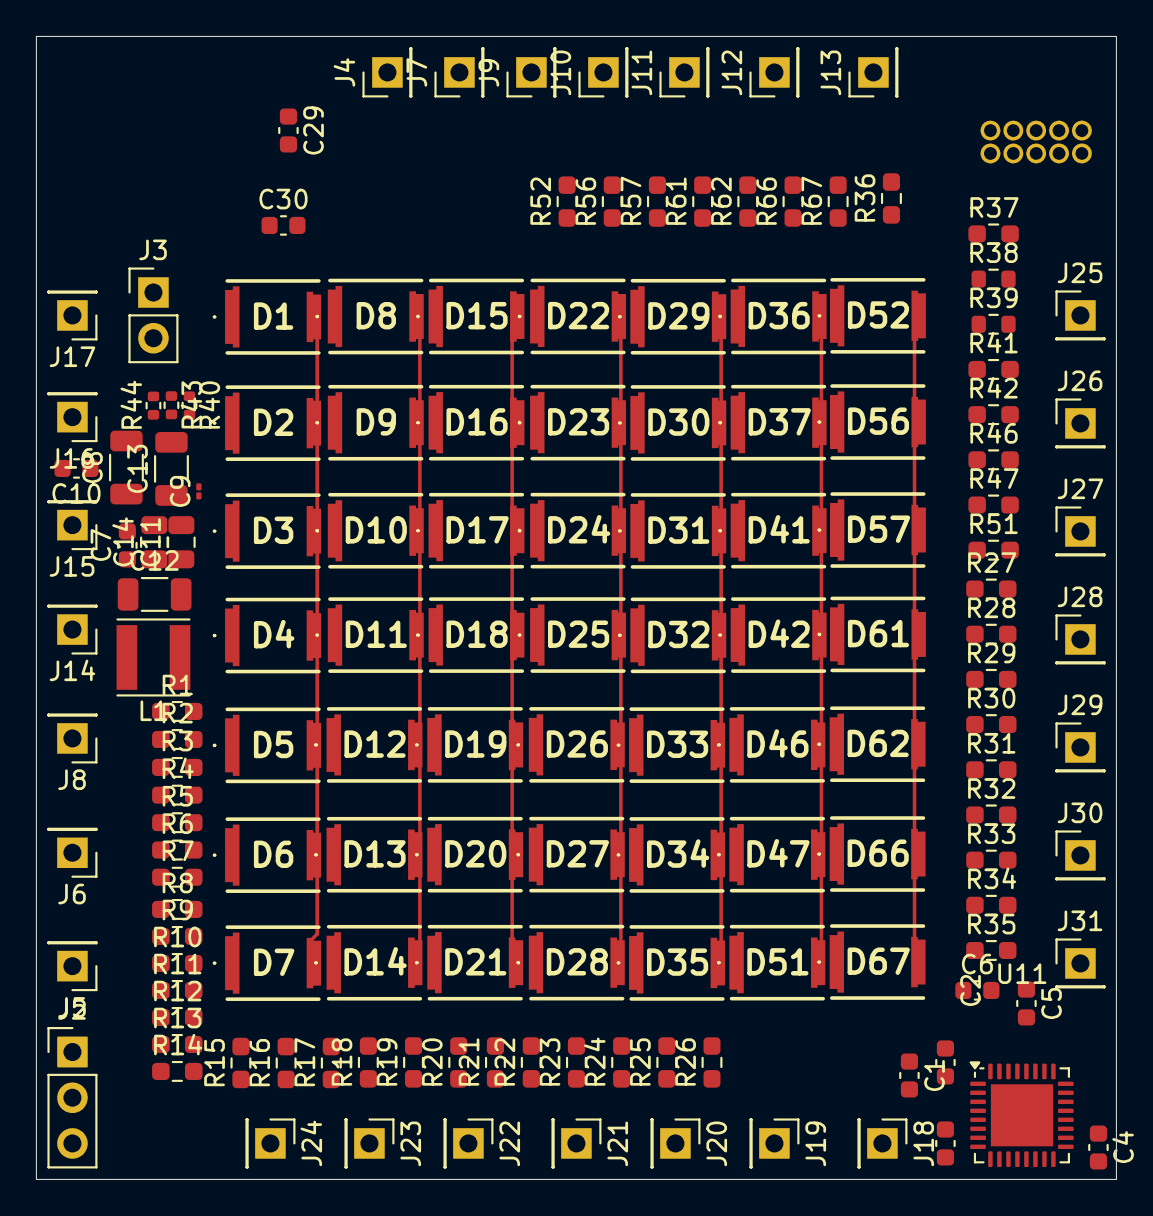
[picture p10: board SunSensor.kicad_pcb from above]

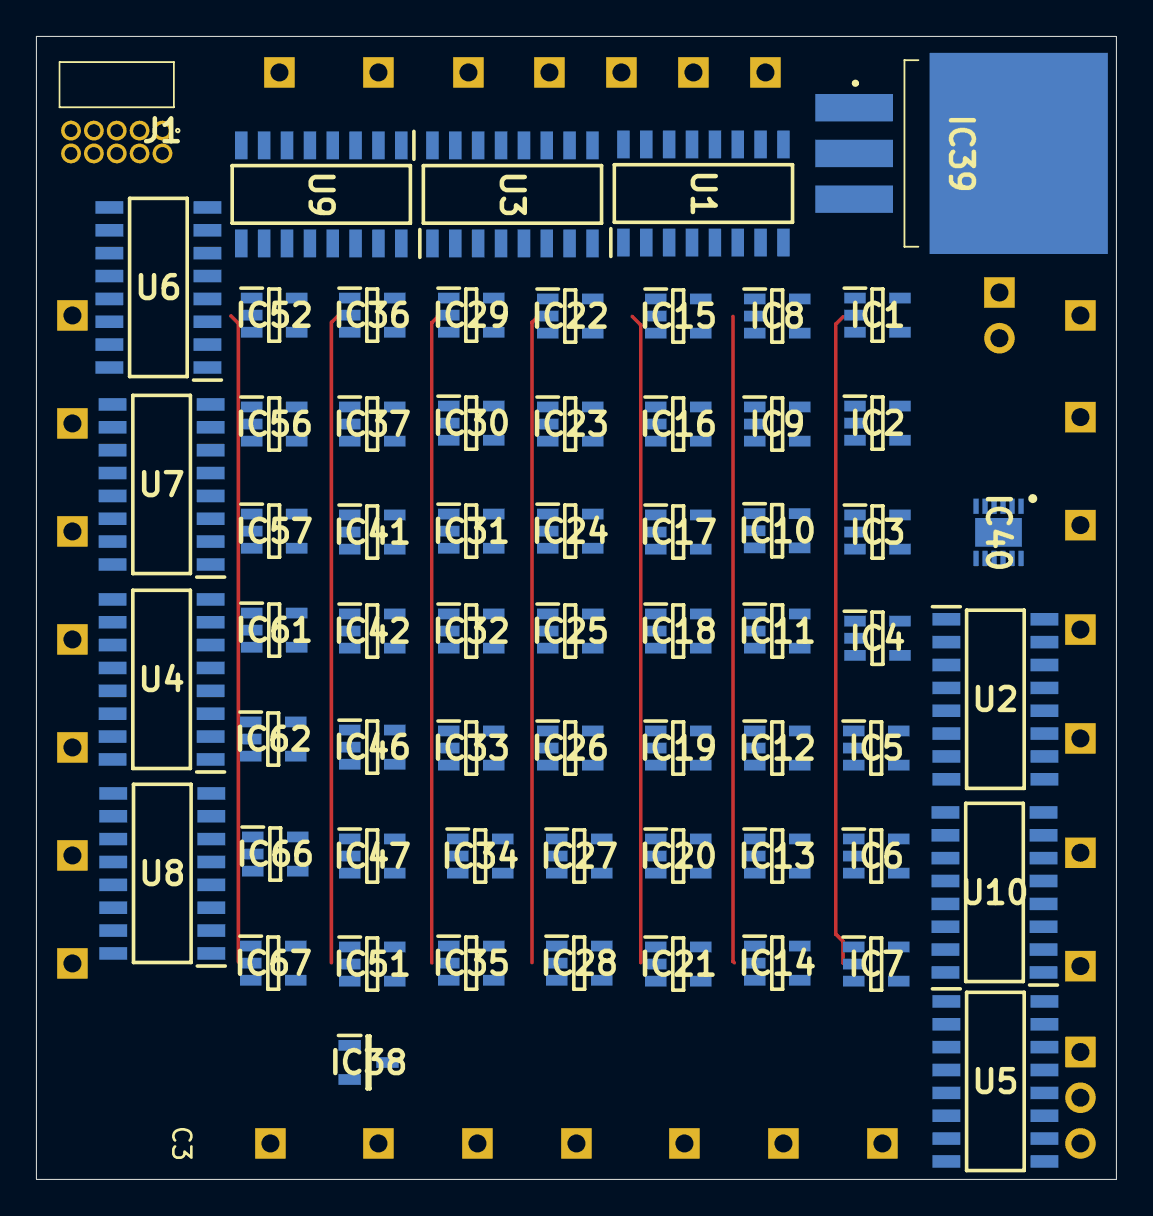
[picture p11: board SunSensor.kicad_pcb from below]

Board: 4 copper layers, 60.0 x 63.5 mm, 214 parts (63 on the bottom side), 156 nets.
